andouglasjr/EmbarcadosPCB/analog.kicad_sch

## KiCad design analog.kicad_sch (2025-02-26)

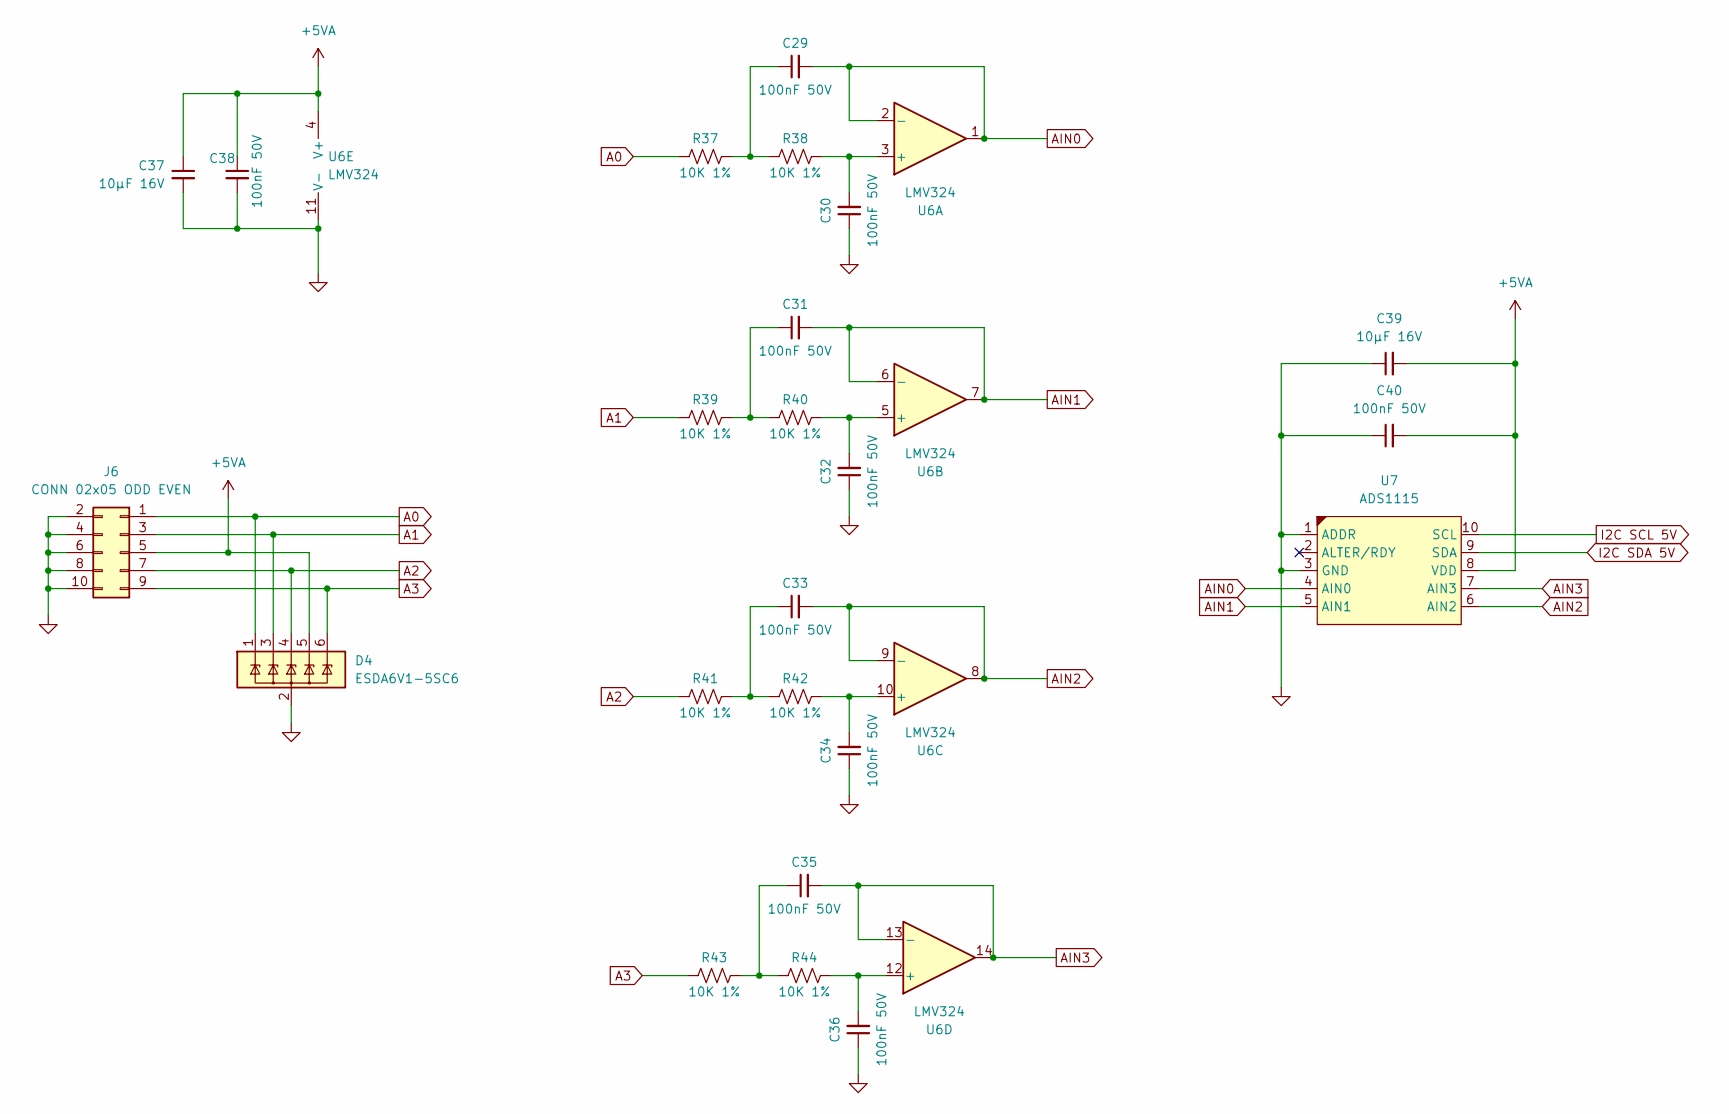
[picture p1: schematic analog.kicad_sch]

Parts:
C29, C30, C31, C32, C33, C34, C35, C36, C38, C40: 100nF 50V; C_0603_1608Metric; MPN KGM15BR71H104K; LCSC Part # C14663
C37, C39: 10µF 16V; C_0805_2012Metric; MPN KGM21AR71C106K; LCSC Part # C15850
D4: ESDA6V1-5SC6; SOT-23-6; MPN ESDA6V1-5SC6; LCSC Part # C2827672
J6: CONN 02x05 ODD EVEN; PinSocket_2x05_P2.54mm_Horizontal; MPN 613010243121
R37, R38, R39, R40, R41, R42, R43, R44: 10K 1%; R_0603_1608Metric; MPN CRCW060310K0FK; LCSC Part # C25804
U6: LMV324; TSSOP-14_4.4x5mm_P0.65mm; MPN LMV324IPT; LCSC Part # C398929
U7: ADS1115; TSSOP-10_3x3mm_P0.5mm; MPN ADS1115IDGSR; LCSC Part # C37593

Connections:
+5VA: C37.1, C38.1, C39.2, C40.2, D4.5 (IO4), J6.5, U6.4 (V+), U7.8 (VDD)
A0: D4.1 (IO1), J6.1, R37.1
A1: D4.3 (IO2), J6.3, R39.1
A2: D4.4 (IO3), J6.7, R41.1
A3: D4.6 (IO5), J6.9, R43.1
AIN0: C29.2, U6.1, U6.2 (-), U7.4 (AIN0)
AIN1: C31.2, U6.6 (-), U6.7, U7.5 (AIN1)
AIN2: C33.2, U6.8, U6.9 (-), U7.6 (AIN2)
AIN3: C35.2, U6.13 (-), U6.14, U7.7 (AIN3)
GND: C30.1, C32.1, C34.1, C36.1, C37.2, C38.2, C39.1, C40.1, D4.2 (GND), J6.2, J6.4, J6.6, J6.8, J6.10, U6.11 (V-), U7.1 (ADDR), U7.3 (GND)
I2C SCL 5V: U7.10 (SCL)
I2C SDA 5V: U7.9 (SDA)
unnamed: C29.1, R37.2, R38.1
unnamed: C30.2, R38.2, U6.3 (+)
unnamed: C31.1, R39.2, R40.1
unnamed: C32.2, R40.2, U6.5 (+)
unnamed: C33.1, R41.2, R42.1
unnamed: C34.2, R42.2, U6.10 (+)
unnamed: C35.1, R43.2, R44.1
unnamed: C36.2, R44.2, U6.12 (+)
