andouglasjr/EmbarcadosPCB/auxiliar.kicad_sch

## KiCad design auxiliar.kicad_sch (2025-02-26)

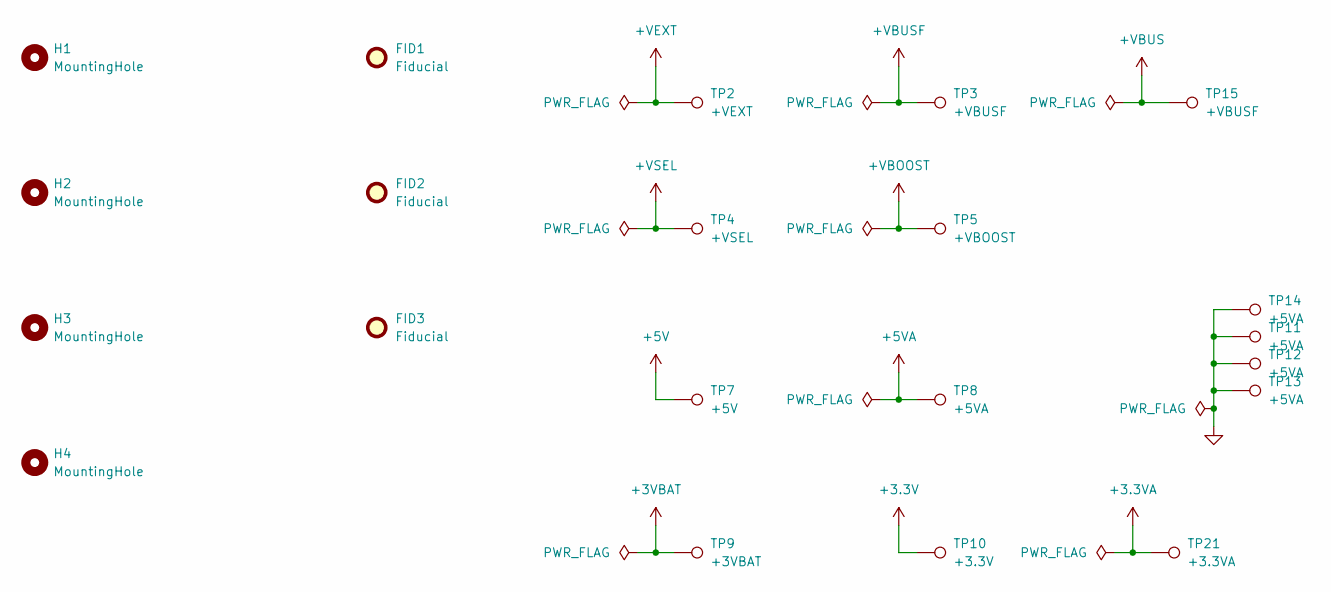
[picture p2: schematic auxiliar.kicad_sch]

Parts:
FID1, FID2, FID3: Fiducial; Fiducial_0.75mm_Mask1.5mm
H1, H2, H3, H4: MountingHole; MountingHole_3.2mm_M3
TP2: +VEXT; TestPoint_Keystone_5000-5004_Miniature
TP3, TP15: +VBUSF; TestPoint_Keystone_5000-5004_Miniature
TP4: +VSEL; TestPoint_Keystone_5000-5004_Miniature
TP5: +VBOOST; TestPoint_Keystone_5000-5004_Miniature
TP7: +5V; TestPoint_Keystone_5000-5004_Miniature
TP8, TP11, TP12, TP13, TP14: +5VA; TestPoint_Keystone_5000-5004_Miniature
TP9: +3VBAT; TestPoint_Keystone_5000-5004_Miniature
TP10: +3.3V; TestPoint_Keystone_5000-5004_Miniature
TP21: +3.3VA; TestPoint_Keystone_5000-5004_Miniature

Connections:
+3.3V: TP10.1
+3.3VA: TP21.1
+3VBAT: TP9.1
+5V: TP7.1
+5VA: TP8.1
+VBOOST: TP5.1
+VBUS: TP15.1
+VBUSF: TP3.1
+VEXT: TP2.1
+VSEL: TP4.1
GND: TP11.1, TP12.1, TP13.1, TP14.1
