andouglasjr/EmbarcadosPCB/interface.kicad_sch

## KiCad design interface.kicad_sch (2025-02-26)

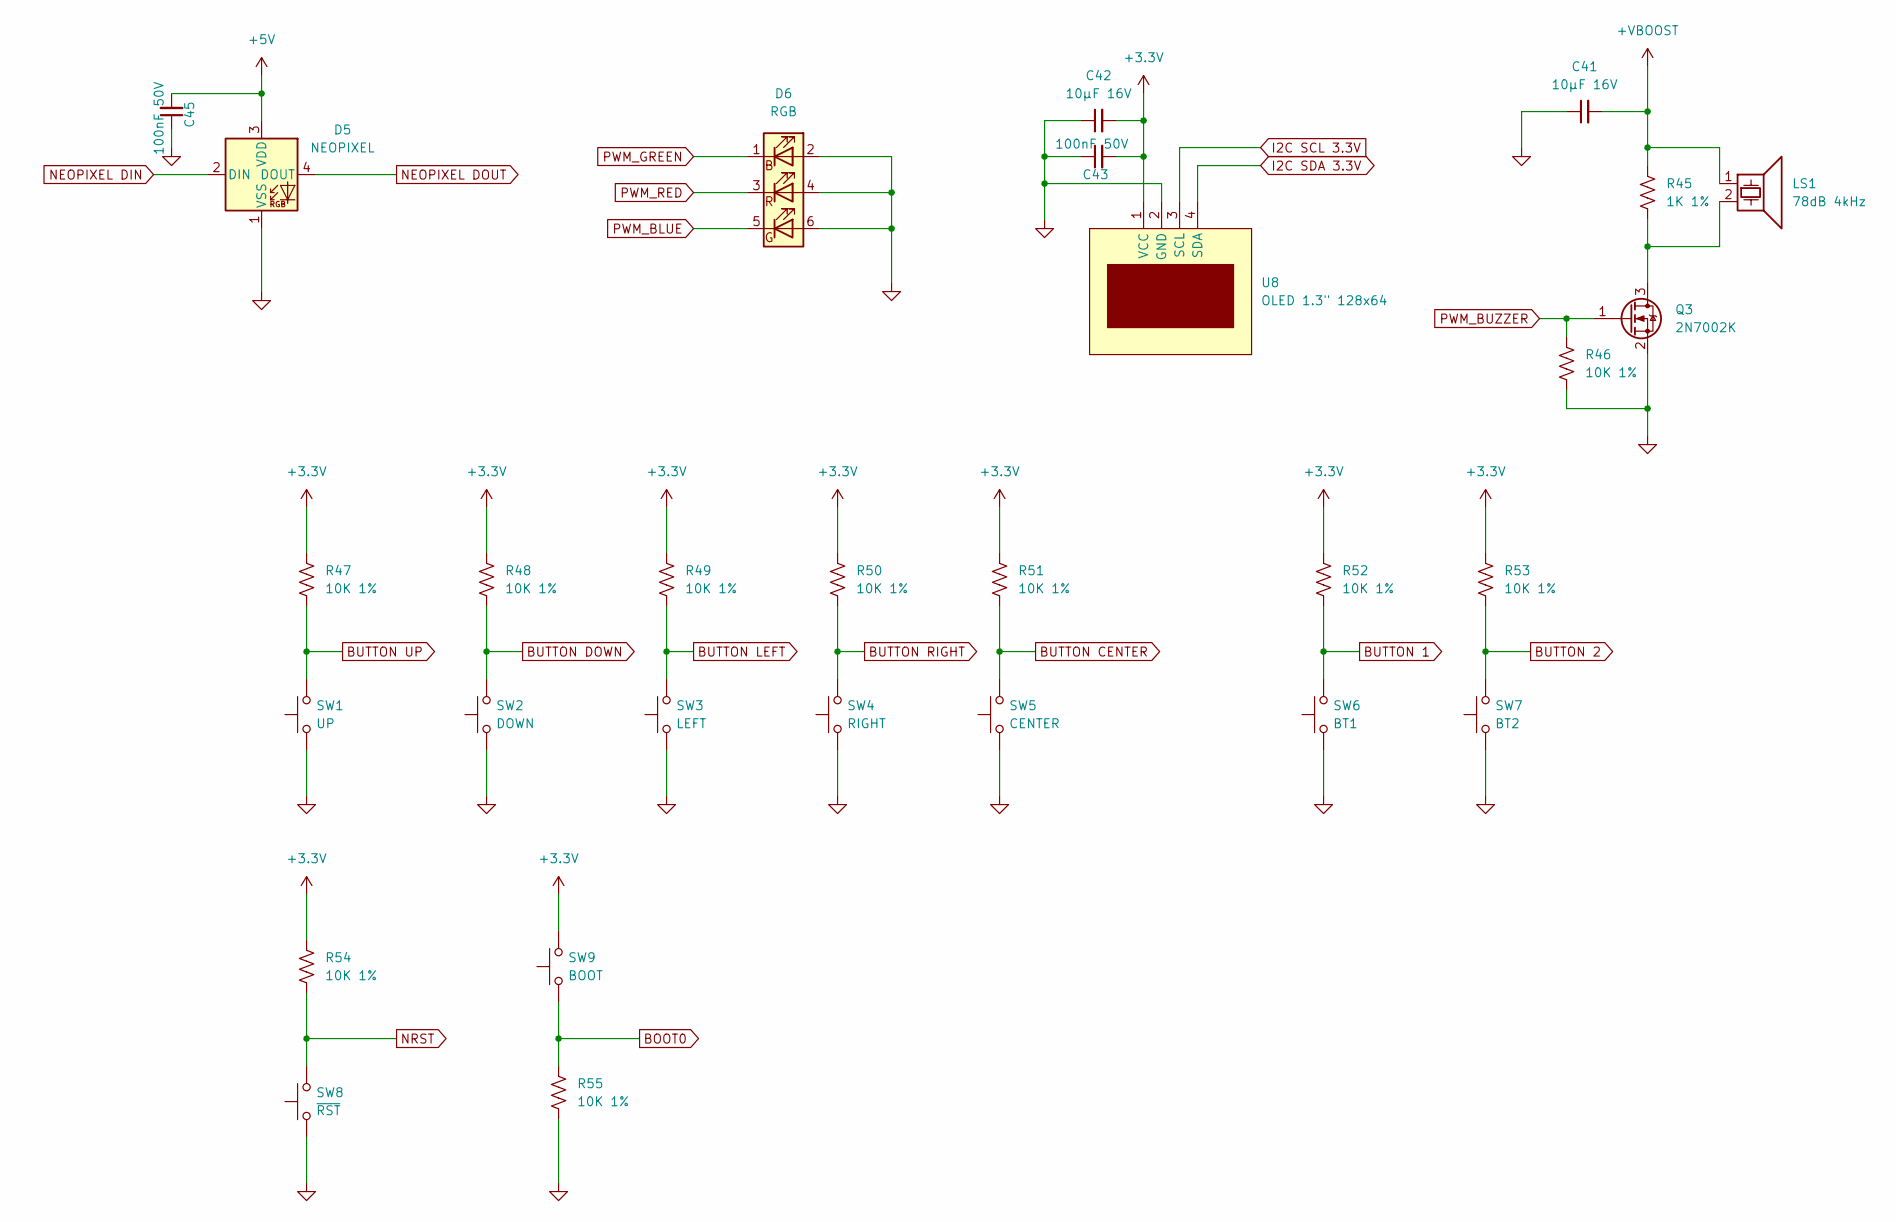
[picture p3: schematic interface.kicad_sch]

Parts:
C41, C42: 10µF 16V; C_0805_2012Metric; MPN KGM21AR71C106K; LCSC Part # C15850
C43, C45: 100nF 50V; C_0603_1608Metric; MPN KGM15BR71H104K; LCSC Part # C14663
D5: NEOPIXEL; LED_WS2812B_PLCC4_5.0x5.0mm_P3.2mm; MPN 1315050930002
D6: RGB; LED_Inolux_IN-P55TATRGB_PLCC6_5.0x5.5mm_P1.8mm; MPN 150505M173300
LS1: 78dB 4kHz; PKM13EPYH4000-A0; MPN PKM13EPYH4000-A0
Q3: 2N7002K; SOT-23; MPN 2N7002K-7; LCSC Part # C8545
R45: 1K 1%; R_0603_1608Metric; MPN CRCW06031K00FK; LCSC Part # C21190
R46, R47, R48, R49, R50, R51, R52, R53, R54, R55: 10K 1%; R_0603_1608Metric; MPN CRCW060310K0FK; LCSC Part # C25804
SW1: UP; C&K PTS526SM20SMTR21 LFS; MPN PTS526SM20SMTR21 LFS; LCSC Part # C318884
SW2: DOWN; C&K PTS526SM20SMTR21 LFS; MPN PTS526SM20SMTR21 LFS; LCSC Part # C318884
SW3: LEFT; C&K PTS526SM20SMTR21 LFS; MPN PTS526SM20SMTR21 LFS; LCSC Part # C318884
SW4: RIGHT; C&K PTS526SM20SMTR21 LFS; MPN PTS526SM20SMTR21 LFS; LCSC Part # C318884
SW5: CENTER; C&K PTS526SM20SMTR21 LFS; MPN PTS526SM20SMTR21 LFS; LCSC Part # C318884
SW6: BT1; C&K PTS526SM20SMTR21 LFS; MPN PTS526SM20SMTR21 LFS; LCSC Part # C318884
SW7: BT2; C&K PTS526SM20SMTR21 LFS; MPN PTS526SM20SMTR21 LFS; LCSC Part # C318884
SW8: ~{RST}; C&K PTS526SM20SMTR21 LFS; MPN PTS526SM20SMTR21 LFS; LCSC Part # C318884
SW9: BOOT; C&K PTS526SM20SMTR21 LFS; MPN PTS526SM20SMTR21 LFS; LCSC Part # C318884
U8: OLED 1.3" 128x64; OLED 128x64 1.3in; MPN 61300411821

Connections:
+3.3V: C42.2, C43.2, R47.1, R48.1, R49.1, R50.1, R51.1, R52.1, R53.1, R54.1, SW9.2 (B), U8.1 (VCC)
+5V: C45.2, D5.3 (VDD)
+VBOOST: C41.2, LS1.1, R45.1
BOOT0: R55.1, SW9.1 (A)
BUTTON 1: R52.2, SW6.2 (B)
BUTTON 2: R53.2, SW7.2 (B)
BUTTON CENTER: R51.2, SW5.2 (B)
BUTTON DOWN: R48.2, SW2.2 (B)
BUTTON LEFT: R49.2, SW3.2 (B)
BUTTON RIGHT: R50.2, SW4.2 (B)
BUTTON UP: R47.2, SW1.2 (B)
GND: C41.1, C42.1, C43.1, C45.1, D5.1 (VSS), D6.2 (GK), D6.4 (BA), D6.6 (RA), Q3.2 (S), R46.2, R55.2, SW1.1 (A), SW2.1 (A), SW3.1 (A), SW4.1 (A), SW5.1 (A), SW6.1 (A), SW7.1 (A), SW8.1 (A), U8.2 (GND)
I2C SCL 3.3V: U8.3 (SCL)
I2C SDA 3.3V: U8.4 (SDA)
NEOPIXEL DIN: D5.2 (DIN)
NEOPIXEL DOUT: D5.4 (DOUT)
NRST: R54.2, SW8.2 (B)
unnamed: LS1.2, Q3.3 (D), R45.2
PWM_BLUE: D6.5 (GA)
PWM_BUZZER: Q3.1 (G), R46.1
PWM_GREEN: D6.1 (RK)
PWM_RED: D6.3 (BK)
