andouglasjr/EmbarcadosPCB/io.kicad_sch

## KiCad design io.kicad_sch (2025-02-26)

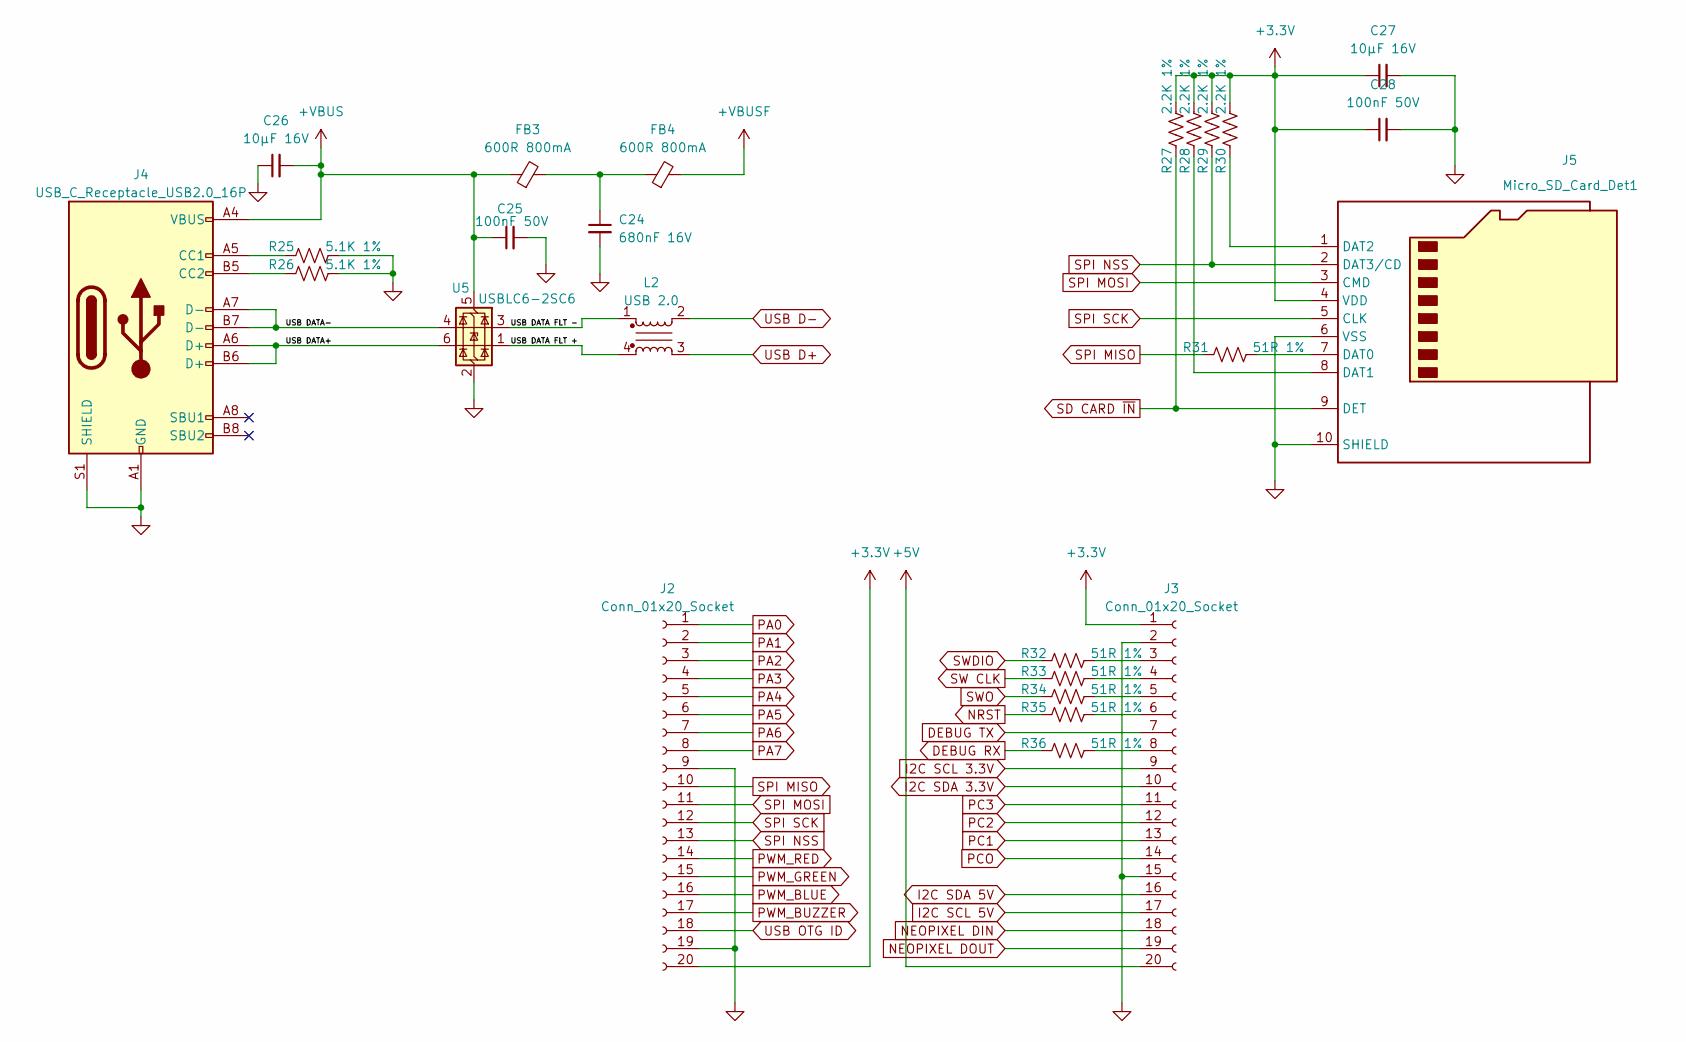
[picture p4: schematic io.kicad_sch]

Parts:
C24: 680nF 16V; C_0603_1608Metric; MPN KGM15BR71C684M; LCSC Part # C327005
C25, C28: 100nF 50V; C_0603_1608Metric; MPN KGM15BR71H104K; LCSC Part # C14663
C26, C27: 10µF 16V; C_0805_2012Metric; MPN KGM21AR71C106K; LCSC Part # C15850
FB3, FB4: 600R 800mA; L_0603_1608Metric; MPN 742792651; LCSC Part # C963865
J2, J3: Conn_01x20_Socket; PinSocket_1x20_P2.54mm_Horizontal; MPN 613020143121
J4: USB_C_Receptacle_USB2.0_16P; USB_C_Receptacle_G-Switch_GT-USB-7010ASV; MPN 629722000214; LCSC Part # C2927038
J5: Micro_SD_Card_Det1; WE 693071020811; MPN 693071020811; LCSC Part # C19189038
L2: USB 2.0; WE-CNSW SMT Common Mode Line Filter; MPN 744232090
R25, R26: 5.1K 1%; R_0603_1608Metric; MPN CRCW06035K10FK; LCSC Part # C23186
R27, R28, R29, R30: 2.2K 1%; R_0603_1608Metric; MPN CRCW06032K20FK; LCSC Part # C4190
R31, R32, R33, R34, R35, R36: 51R 1%; R_0603_1608Metric; MPN CRCW060351R0FK; LCSC Part # C23197
U5: USBLC6-2SC6; SOT-23-6; MPN USBLC6-2SC6; LCSC Part # C2827654

Connections:
+3.3V: C27.1, C28.1, J2.20, J3.1, J5.4 (VDD), R27.1, R28.1, R29.1, R30.1
+5V: J3.20
+VBUS: C25.1, C26.2, FB3.1, J4.A4 (VBUS), J4.A9 (VBUS), J4.B4 (VBUS), J4.B9 (VBUS), U5.5 (VBUS)
+VBUSF: FB4.2
DEBUG RX: R36.1
DEBUG TX: J3.7
GND: C24.2, C25.2, C26.1, C27.2, C28.2, J2.9, J2.19, J3.2, J3.15, J4.A1 (GND), J4.A12 (GND), J4.B1 (GND), J4.B12 (GND), J4.S1 (SHIELD), J5.6 (VSS), J5.10 (SHIELD), J5.11 (SHIELD), J5.12 (SHIELD), J5.13 (SHIELD), R25.2, R26.2, U5.2 (GND)
I2C SCL 3.3V: J3.9
I2C SCL 5V: J3.17
I2C SDA 3.3V: J3.10
I2C SDA 5V: J3.16
NEOPIXEL DIN: J3.18
NEOPIXEL DOUT: J3.19
NRST: R35.1
unnamed: C24.1, FB3.2, FB4.1
unnamed: J3.3, R32.2
unnamed: J3.4, R33.2
unnamed: J3.5, R34.2
unnamed: J3.6, R35.2
unnamed: J3.8, R36.2
unnamed: J4.A5 (CC1), R25.1
unnamed: J4.B5 (CC2), R26.1
unnamed: J5.1 (DAT2), R30.2
unnamed: J5.7 (DAT0), R31.2
unnamed: J5.8 (DAT1), R28.2
PA0: J2.1
PA1: J2.2
PA2: J2.3
PA3: J2.4
PA4: J2.5
PA5: J2.6
PA6: J2.7
PA7: J2.8
PC1: J3.13
PC2: J3.12
PC3: J3.11
PCO: J3.14
PWM_BLUE: J2.16
PWM_BUZZER: J2.17
PWM_GREEN: J2.15
PWM_RED: J2.14
SD CARD ~IN: J5.9 (DET), R27.2
SPI MISO: J2.10, R31.1
SPI MOSI: J2.11, J5.3 (CMD)
SPI NSS: J2.13, J5.2 (DAT3/CD), R29.2
SPI SCK: J2.12, J5.5 (CLK)
SW CLK: R33.1
SWDIO: R32.1
SWO: R34.1
USB D+: L2.3
USB D-: L2.2
USB DATA FLT +: L2.4, U5.1 (I/O1)
USB DATA FLT -: L2.1, U5.3 (I/O2)
USB DATA+: J4.A6 (D+), J4.B6 (D+), U5.6 (I/O1)
USB DATA-: J4.A7 (D-), J4.B7 (D-), U5.4 (I/O2)
USB OTG ID: J2.18
