andouglasjr/EmbarcadosPCB/mcu.kicad_sch

## KiCad design mcu.kicad_sch (2025-02-26)

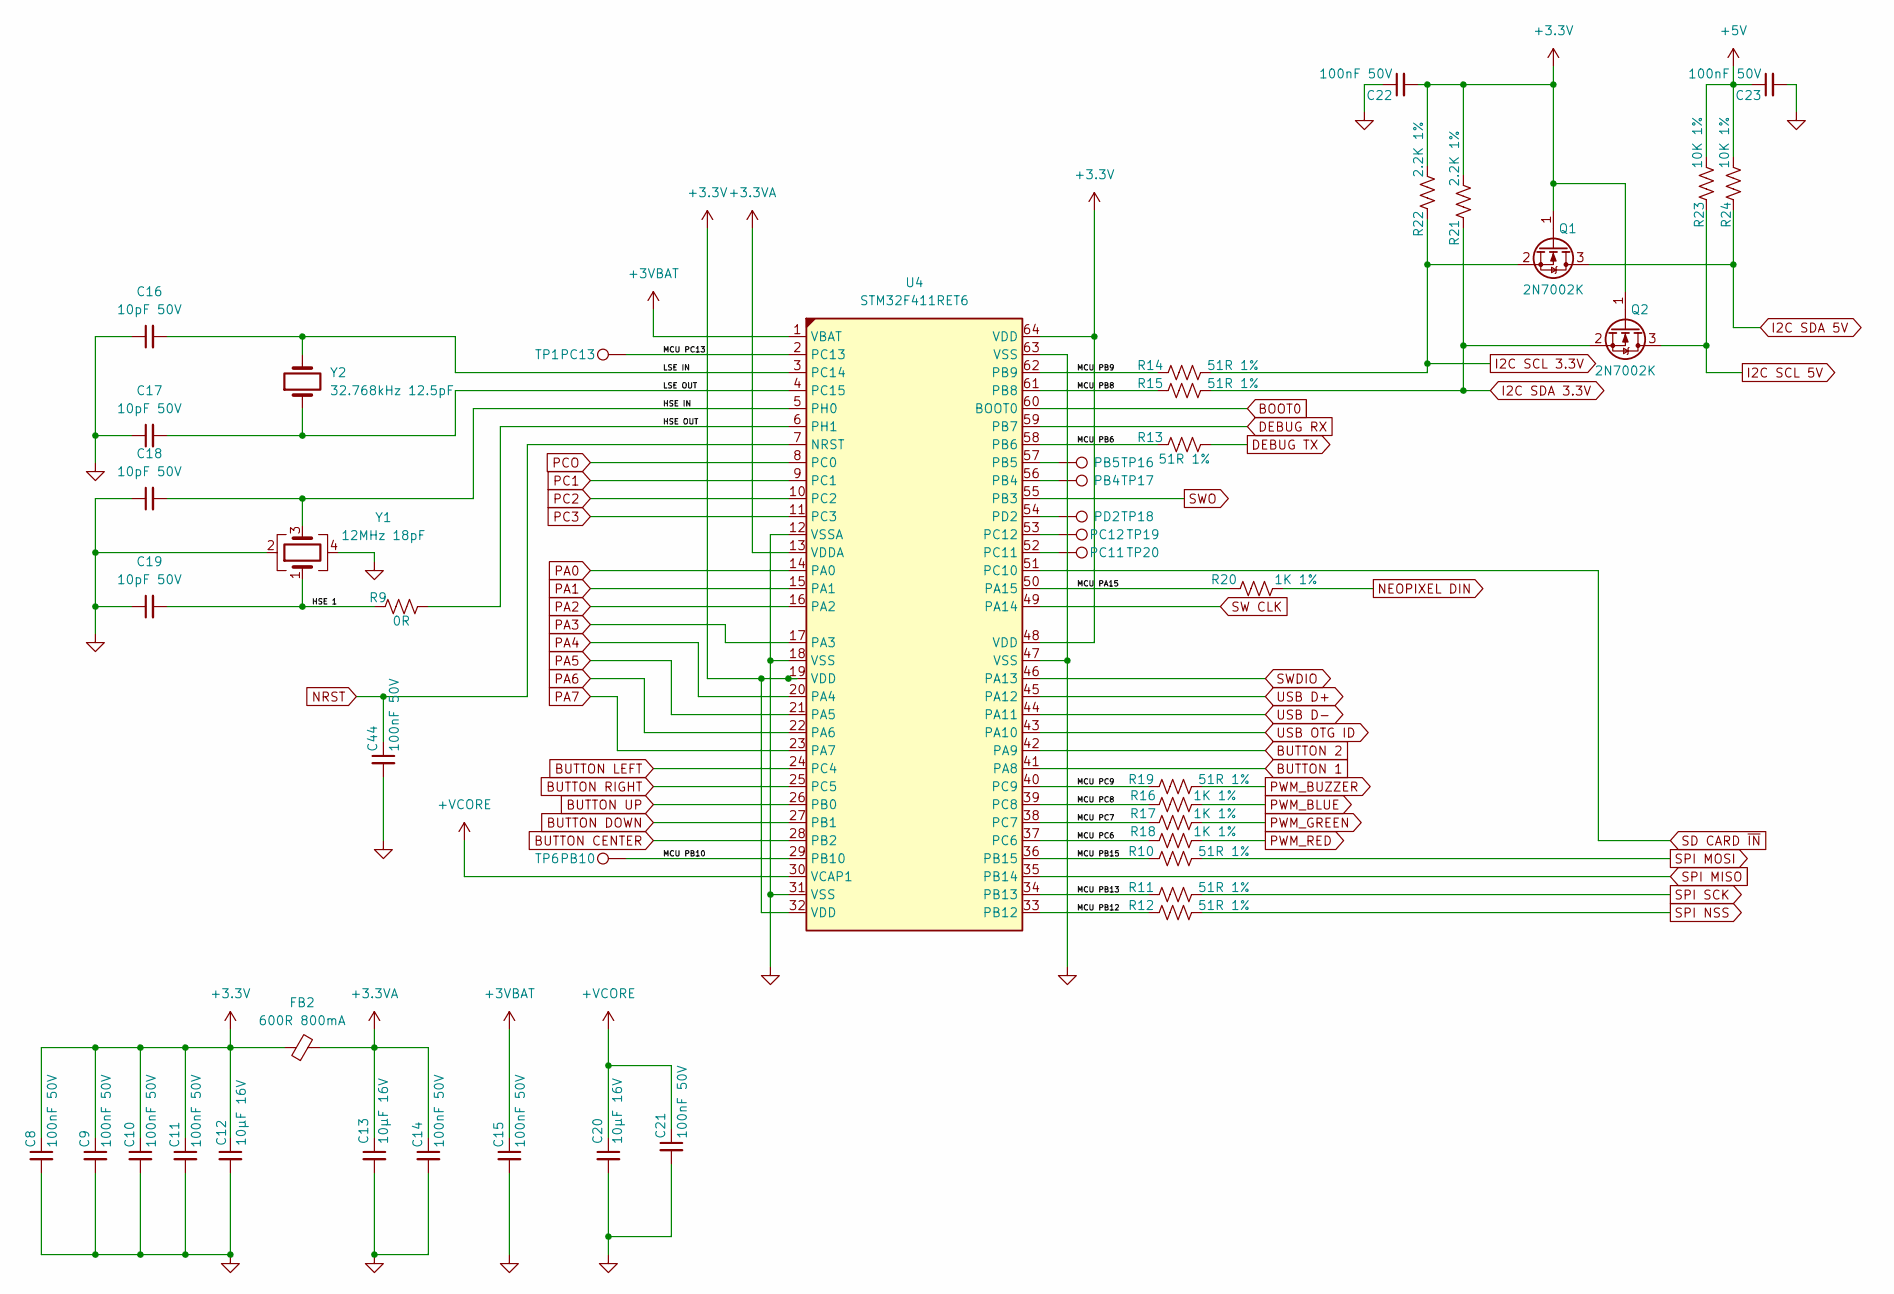
[picture p5: schematic mcu.kicad_sch]

Parts:
C8, C9, C10, C11, C14, C15, C21, C22, C23, C44: 100nF 50V; C_0603_1608Metric; MPN KGM15BR71H104K; LCSC Part # C14663
C12, C13, C20: 10µF 16V; C_0805_2012Metric; MPN KGM21AR71C106K; LCSC Part # C15850
C16, C17, C18, C19: 10pF 50V; C_0603_1608Metric; MPN KGM15ACG1H100G; LCSC Part # C1634
FB2: 600R 800mA; L_0603_1608Metric; MPN 742792651; LCSC Part # C963865
Q1, Q2: 2N7002K; SOT-23; MPN 2N7002K-7; LCSC Part # C8545
R9: 0R; R_0603_1608Metric; MPN CRCW06030000Z0; LCSC Part # C21189
R10, R11, R12, R13, R14, R15, R19: 51R 1%; R_0603_1608Metric; MPN CRCW060351R0FK; LCSC Part # C23197
R16, R17, R18, R20: 1K 1%; R_0603_1608Metric; MPN CRCW06031K00FK; LCSC Part # C21190
R21, R22: 2.2K 1%; R_0603_1608Metric; MPN CRCW06032K20FK; LCSC Part # C4190
R23, R24: 10K 1%; R_0603_1608Metric; MPN CRCW060310K0FK; LCSC Part # C25804
TP1: PC13; TestPoint_Keystone_5000-5004_Miniature
TP6: PB10; TestPoint_Keystone_5000-5004_Miniature
TP16: PB5; TestPoint_Keystone_5000-5004_Miniature
TP17: PB4; TestPoint_Keystone_5000-5004_Miniature
TP18: PD2; TestPoint_Keystone_5000-5004_Miniature
TP19: PC12; TestPoint_Keystone_5000-5004_Miniature
TP20: PC11; TestPoint_Keystone_5000-5004_Miniature
U4: STM32F411RET6; LQFP-64_10x10mm_P0.5mm; MPN STM32F411RET6; LCSC Part # C94355
Y1: 12MHz 18pF; Crystal_SMD_3225-4Pin_3.2x2.5mm; MPN ABM8-12.000MHZ-D2Y-T; LCSC Part # C6071564
Y2: 32.768kHz 12.5pF; Crystal_SMD_3215-2Pin_3.2x1.5mm; MPN ABS06-32.768KHZ-T; LCSC Part # C5563819

Connections:
+3.3V: C8.1, C9.1, C10.1, C11.1, C12.1, C22.2, FB2.1, Q1.1 (G), Q2.1 (G), R21.1, R22.1, U4.19 (VDD), U4.32 (VDD), U4.48 (VDD), U4.64 (VDD)
+3.3VA: C13.1, C14.1, FB2.2, U4.13 (VDDA)
+3VBAT: C15.1, U4.1 (VBAT)
+5V: C23.1, R23.1, R24.1
+VCORE: C20.1, C21.1, U4.30 (VCAP1)
BOOT0: U4.60 (BOOT0)
BUTTON 1: U4.41 (PA8)
BUTTON 2: U4.42 (PA9)
BUTTON CENTER: U4.28 (PB2)
BUTTON DOWN: U4.27 (PB1)
BUTTON LEFT: U4.24 (PC4)
BUTTON RIGHT: U4.25 (PC5)
BUTTON UP: U4.26 (PB0)
DEBUG RX: U4.59 (PB7)
DEBUG TX: R13.2
GND: C8.2, C9.2, C10.2, C11.2, C12.2, C13.2, C14.2, C15.2, C16.1, C17.1, C18.1, C19.1, C20.2, C21.2, C22.1, C23.2, C44.2, U4.12 (VSSA), U4.18 (VSS), U4.31 (VSS), U4.47 (VSS), U4.63 (VSS), Y1.2, Y1.4
HSE 1: C19.2, R9.1, Y1.1
HSE IN: C18.2, U4.5 (PH0), Y1.3
HSE OUT: R9.2, U4.6 (PH1)
I2C SCL 3.3V: Q1.2 (S), R14.2, R22.2
I2C SCL 5V: Q2.3 (D), R23.2
I2C SDA 3.3V: Q2.2 (S), R15.2, R21.2
I2C SDA 5V: Q1.3 (D), R24.2
LSE IN: C16.2, U4.3 (PC14), Y2.2
LSE OUT: C17.2, U4.4 (PC15), Y2.1
MCU PA15: R20.1, U4.50 (PA15)
MCU PB6: R13.1, U4.58 (PB6)
MCU PB8: R15.1, U4.61 (PB8)
MCU PB9: R14.1, U4.62 (PB9)
MCU PB10: TP6.1, U4.29 (PB10)
MCU PB12: R12.1, U4.33 (PB12)
MCU PB13: R11.1, U4.34 (PB13)
MCU PB15: R10.1, U4.36 (PB15)
MCU PC6: R18.1, U4.37 (PC6)
MCU PC7: R17.1, U4.38 (PC7)
MCU PC8: R16.1, U4.39 (PC8)
MCU PC9: R19.1, U4.40 (PC9)
MCU PC13: TP1.1, U4.2 (PC13)
NEOPIXEL DIN: R20.2
NRST: C44.1, U4.7 (NRST)
unnamed: TP16.1, U4.57 (PB5)
unnamed: TP17.1, U4.56 (PB4)
unnamed: TP18.1, U4.54 (PD2)
unnamed: TP19.1, U4.53 (PC12)
unnamed: TP20.1, U4.52 (PC11)
PA0: U4.14 (PA0)
PA1: U4.15 (PA1)
PA2: U4.16 (PA2)
PA3: U4.17 (PA3)
PA4: U4.20 (PA4)
PA5: U4.21 (PA5)
PA6: U4.22 (PA6)
PA7: U4.23 (PA7)
PC1: U4.9 (PC1)
PC2: U4.10 (PC2)
PC3: U4.11 (PC3)
PCO: U4.8 (PC0)
PWM_BLUE: R16.2
PWM_BUZZER: R19.2
PWM_GREEN: R17.2
PWM_RED: R18.2
SD CARD ~IN: U4.51 (PC10)
SPI MISO: U4.35 (PB14)
SPI MOSI: R10.2
SPI NSS: R12.2
SPI SCK: R11.2
SW CLK: U4.49 (PA14)
SWDIO: U4.46 (PA13)
SWO: U4.55 (PB3)
USB D+: U4.45 (PA12)
USB D-: U4.44 (PA11)
USB OTG ID: U4.43 (PA10)
