andouglasjr/EmbarcadosPCB/power.kicad_sch

## KiCad design power.kicad_sch (2025-02-26)

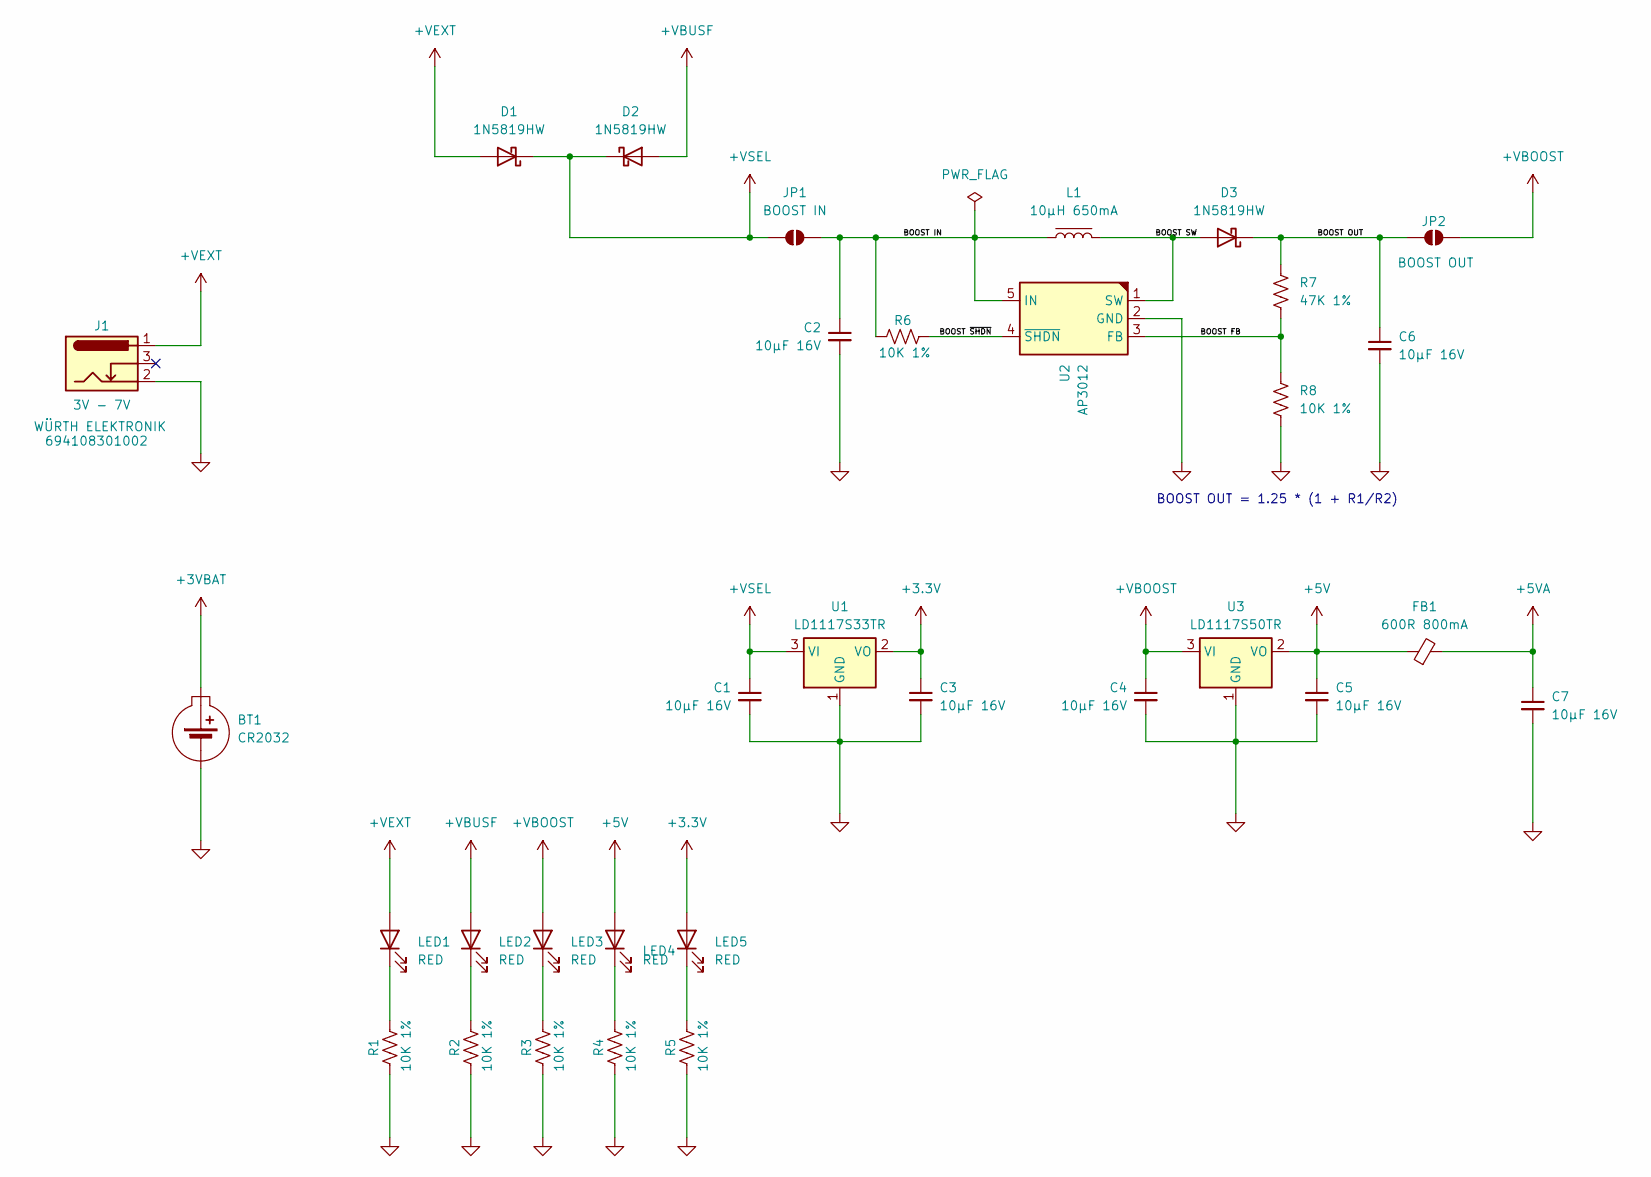
[picture p6: schematic power.kicad_sch]

Parts:
BT1: CR2032; BatteryHolder_Keystone_1060_1x2032; MPN 79527141
C1, C2, C3, C4, C5, C6, C7: 10µF 16V; C_0805_2012Metric; MPN KGM21AR71C106K; LCSC Part # C15850
D1, D2, D3: 1N5819HW; D_SOD-123; MPN 1N5819HW-7-F; LCSC Part # C82544
FB1: 600R 800mA; L_0603_1608Metric; MPN 742792651; LCSC Part # C963865
J1: 3V - 7V; BarrelJack_GCT_DCJ200-10-A_Horizontal; MPN 694108301002
JP1: BOOST IN; SolderJumper-2_P1.3mm_Open_RoundedPad1.0x1.5mm
JP2: BOOST OUT; SolderJumper-2_P1.3mm_Open_RoundedPad1.0x1.5mm
L1: 10µH 650mA; WE-LQS SMT Semi-Shielded Power Inductor; MPN 74404024100; LCSC Part # C520138
LED1, LED2, LED3, LED4, LED5: RED; LED_0603_1608Metric; MPN 150060SS55040; LCSC Part # C128052
R1, R2, R3, R4, R5, R6, R8: 10K 1%; R_0603_1608Metric; MPN CRCW060310K0FK; LCSC Part # C25804
R7: 47K 1%; R_0603_1608Metric; MPN CRCW060347K0FK; LCSC Part # C25819
U1: LD1117S33TR; SOT-223-3_TabPin2; MPN LD1117S33TR; LCSC Part # C6186
U2: AP3012; SOT-23-5; MPN AP3012KTR-E1; LCSC Part # C460356
U3: LD1117S50TR; SOT-223-3_TabPin2; MPN LD1117S50TR; LCSC Part # C6187

Connections:
+3.3V: C3.1, LED5.2 (A), U1.2 (VO)
+3VBAT: BT1.1 (+)
+5V: C5.1, FB1.1, LED4.2 (A), U3.2 (VO)
+5VA: C7.1, FB1.2
+VBOOST: C4.1, JP2.2 (B), LED3.2 (A), U3.3 (VI)
+VBUSF: D2.2 (A), LED2.2 (A)
+VEXT: D1.2 (A), J1.1, LED1.2 (A)
+VSEL: C1.1, D1.1 (K), D2.1 (K), JP1.1 (A), U1.3 (VI)
BOOST FB: R7.2, R8.1, U2.3 (FB)
BOOST IN: C2.1, JP1.2 (B), L1.1, R6.1, U2.5 (IN)
BOOST OUT: C6.1, D3.1 (K), JP2.1 (A), R7.1
BOOST SW: D3.2 (A), L1.2, U2.1 (SW)
BOOST ~SHDN: R6.2, U2.4 (~SHDN)
GND: BT1.2 (-), C1.2, C2.2, C3.2, C4.2, C5.2, C6.2, C7.2, J1.2, R1.1, R2.1, R3.1, R4.1, R5.1, R8.2, U1.1 (GND), U2.2 (GND), U3.1 (GND)
unnamed: LED1.1 (K), R1.2
unnamed: LED2.1 (K), R2.2
unnamed: LED3.1 (K), R3.2
unnamed: LED4.1 (K), R4.2
unnamed: LED5.1 (K), R5.2

Notes on the sheet:
BOOST OUT = 1.25 * (1 + R1/R2)
